dev65808/chipathon-2026-SILICON_RISC-V/gds/README.md

# File History

- `qspi_chip_top.gds`: Latest GDS on 09/05 with fixed stdcell holes and strong power connections.
- `qspi_chip_top_0905.gds`: GDS with std holes fixed but weak power
- `qspi_chip_top_holes.gds`: GDS before the std hole fixed on 09/05
- Old ones
  - `qspi_chip_top_orig.gds`: 
  - `qspi_chip _top_orig_holes.gds`
