dev65808/chipathon-2026-SILICON_RISC-V/librelane/Hardened Scripts/config.yaml

meta:
  version: 3
  flow: Classic
  substituting_steps:

    # Disable KLayout DRC
    #KLayout.DRC: null
    #Checker.KLayoutDRC: null

    # Disable KLayout antenna check
    #KLayout.Antenna: null
    #Checker.KLayoutAntenna: null

    # Disable KLayout density check
    #KLayout.Density: null
    #Checker.KLayoutDensity: null

    # Save time during development
    # Enable for sign-off
    #OpenROAD.IRDropReport: null
    #Magic.DRC: null
    #Checker.MagicDRC: null
    #KLayout.XOR: null
    #Netgen.LVS: null
    #Checker.LVS: null

DESIGN_NAME: qspi_chip_top

VERILOG_FILES:

- dir::../src/qspi_chip_top.sv
- dir::../src/rv32i_core.sv
- dir::../src/rv32i_qspi_mem.v
- dir::../src/qspi_ctrl.v
- dir::../src/uart_riscv_if.v
- dir::../src/uart_rx.v
- dir::../src/uart_tx.v
- dir::../src/spi_riscv_if.v
- dir::../src/spi_ctrl.v
- dir::../src/latch_reg.v


VERILOG_INCLUDE_DIRS:
- dir::../src

FP_SIZING: absolute
DIE_AREA: [0.0, 0.0, 1110.0, 1110.0]
CORE_AREA: [30.0, 30.0, 1080.0, 1080.0]


# Enable plugin for better SystemVerilog support
USE_SLANG: True
SLANG_ARGUMENTS: ['--keep-hierarchy']

# Slightly smaller file sizes
PRIMARY_GDSII_STREAMOUT_TOOL: klayout

# SDC files
PNR_SDC_FILE: dir::qspi_1200.sdc
SIGNOFF_SDC_FILE: dir::qspi_1200.sdc
FALLBACK_SDC: dir::qspi_1200.sdc

# Power / ground nets
VDD_NETS:
- VDD
GND_NETS:
- VSS

# We need to add gf180mcu_fd_io__bi_24t
# due to the unused Y output for output only pads
# COMMENTED OUT -- no padring in this run
#IGNORE_DISCONNECTED_MODULES:
#- gf180mcu_fd_io__bi_24t
# - gf180mcu_ws_ip__id    # disabled with chip_top.sv instantiation
# - gf180mcu_ws_ip__logo

# Clock
CLOCK_PORT: clk
#CLOCK_NET: clk_pad/Y only for pads
CLOCK_PERIOD: 140 # ~8.70 MHz
#OUTPUT_CAP_LOAD: 100

# Fix hold violations
PL_RESIZER_HOLD_SLACK_MARGIN: 0.35
GRT_RESIZER_HOLD_SLACK_MARGIN: 0.3

# Increase for more logic
# on your die
PL_TARGET_DENSITY_PCT: 45

# newly added
MAX_FANOUT_CONSTRAINT: 16
GPL_CELL_PADDING: 5
DPL_CELL_PADDING: 4
RT_MAX_LAYER: Metal5
LEFT_MARGIN_MULT: 1
RIGHT_MARGIN_MULT: 1

DIODE_ON_PORTS: none

# Fix antenna violations after DRT
DRT_ANTENNA_REPAIR_ITERS: 2
DRT_ANTENNA_REPAIR_MARGIN: 10 # %

GRT_REPAIR_ANTENNAS: True
RUN_HEURISTIC_DIODE_INSERTION: false

# PDN - Straps
# COMMENTED OUT -- no padring in this run
PDN_VWIDTH: 5
PDN_HWIDTH: 5
PDN_VSPACING: 1
PDN_HSPACING: 1
PDN_VPITCH: 75
PDN_HPITCH: 75

# PDN - Core ring
# COMMENTED OUT -- no padring in this run
PDN_CORE_RING: True
# Maximum metal width without slotting: 30um
PDN_CORE_RING_VWIDTH: 10
PDN_CORE_RING_HWIDTH: 10
PDN_CORE_RING_CONNECT_TO_PADS: False
PDN_ENABLE_PINS: False
PDN_CORE_VERTICAL_LAYER: Metal2
PDN_CORE_HORIZONTAL_LAYER: Metal3

# Due to OpenROAD bug
# https://github.com/The-OpenROAD-Project/OpenROAD/issues/8229
#PL_TIME_DRIVEN: False
#PL_ROUTABILITY_DRIVEN: False

# Do not error on magic DRC violations
# Note: Passing magic DRC is not required for the submission.
# However, it is recommended to fix or carefully review all violations.
ERROR_ON_MAGIC_DRC: False

# Prevent false positive DRC errors in I/O cells
MAGIC_GDS_FLATGLOB:
# For contacts
- "*_CDNS_*"
# Foundry provided SRAMs
- "*$$*"
- "M1_N*"
- "M1_P*"
- "M2_M1*"
- "M3_M2*"
- "nmos_5p0*"
- "nmos_1p2*"
- "pmos_5p0*"
- "pmos_1p2*"
- "via1_*"
- "ypass_gate*"
- "G_ring_*"
# These additional cells must be flattened to get rid of 3.3V devices
# (DUALGATE drawn into high-level cells)
- "dcap_103*"
- "din_*"
- "mux821_*"
- "rdummy_*"
- "pmoscap_*"
- "xdec_*"
- "ypredec*"
- "xpredec*"
- "prexdec_*"
- "xdec8_*"
- "xdec16_*"
- "xdec32_*"
- "sa_*"

# Since we cannot meet the minimum density limit on Metal2,
# ignore active metal on previous and subsequent layers
# (DM.5_DM.7 and DM.4_DM.6). Dummy metal is moved to active
# metal during the precheck.
KLAYOUT_FILLER_OPTIONS:
  Metal2_ignore_active: true

# Because we have multiple power pads for one power domain
# COMMENTED OUT -- no padring in this run
#MAGIC_EXT_UNIQUE: notopports

# chip_id + wafer.space logo disabled for the multimacro example.
# Re-enable for chipathon submissions (chip_id required for tapeout).
MACROS: {}

# No macro PDN connections needed beyond what the PDN grid already
# supplies through chip_id / logo.  Keep the key as an empty list so
# the rest of the config still parses.
# COMMENTED OUT -- no padring in this run
#PDN_MACRO_CONNECTIONS: []

# Halo size around macros while cutting rows.
# Workaround for: https://github.com/The-OpenROAD-Project/OpenROAD/issues/8868
FP_MACRO_HORIZONTAL_HALO: 10
FP_MACRO_VERTICAL_HALO: 10
PDN_HORIZONTAL_HALO: 5
PDN_VERTICAL_HALO: 5

# COMMENTED OUT -- no padring in this run
#PDN_CFG: dir::pdn_cfg.tcl
#STA_CORNERS:
#- nom_tt_025C_5v00
TOP_MARGIN_MULT: 1
BOTTOM_MARGIN_MULT: 1

GRT_ALLOW_CONGESTION: true

CTS_SINK_CLUSTERING_SIZE: 5



FP_DEF_TEMPLATE: dir::A30_A.def
FP_TEMPLATE_MATCH_MODE: permissive

PDN_CFG: dir::pdn_cfg.tcl
FP_TEMPLATE_COPY_POWER_PINS: true

CTS_CLK_BUFFERS:
  - gf180mcu_fd_sc_mcu7t5v0__clkbuf_8
  - gf180mcu_fd_sc_mcu7t5v0__clkbuf_12
  - gf180mcu_fd_sc_mcu7t5v0__clkbuf_16
  - gf180mcu_fd_sc_mcu7t5v0__clkbuf_20
ERROR_ON_PDN_VIOLATIONS: false
DESIGN_REPAIR_MAX_SLEW_PCT: 40
DESIGN_REPAIR_MAX_CAP_PCT: 40
GRT_DESIGN_REPAIR_MAX_SLEW_PCT: 40
GRT_DESIGN_REPAIR_MAX_CAP_PCT: 40
