dev65808/chipathon-2026-SILICON_RISC-V/(commit log)

2026-06-27 Remove makerchip virtual environment from repository
    [pyvenv.cfg]
2026-08-24 Add UART transmitter module implementation
2026-08-24 Add UART RX test for core functionality
2026-08-31 Add metrics.json with design and power metrics
2026-09-05 FIXED weak power connections after stdcell hole fix
2026-09-05 FIXED stdcell holes but weak power connections
2026-09-22 New flags: gf_def_ready, ws_def_ready, drc_ready, lvs_ready
    gf_def_ready: true # data ready for def generation with global foundries' pad frame
    ws_def_ready: false # data ready for def generation with wafer space pad frame
    drc_ready: true # data ready for integration and DRC
    lvs_ready: true # data ready for integrated LVS
2026-09-29 Enhance README with project overview and instructions
    Expanded README to include detailed design, verification, and tapeout flow for the qspi_chip_top project.
2026-09-29 Add setup guide for project from scratch
    This guide provides step-by-step instructions for setting up the project from scratch, including installing Docker, cloning the repository, running the Docker container, exploring the project layout, and running functional verification and the LibreLane flow.
